JosefEly/RadRandom-RNG-project/README.md

# RadRandom-RNG-project
Schematics and code for a hardware RNG project

This project works using a smoke detector AM-241 source and a reverse-biased photodiode. When an alpha particle hits the detector, this registers as a voltage spike which is converted to a digital signal by a comparator (with hysterisis to avoid turning one detection event into two). An Arduino measures the time between two sets of pulses - if A is greater than B, it's a 1, if A < B, it's a 0, and if they are equal, it tries again recursively. Because the generator can only generate so many bits at a time, these bits are generated and then cached, and each roll pulls from the cached file. Because radioactive decay is random at the quantum level, the bits should be too. A Python verison of the NIST statistical test suite thought the bits were in fact random. I attached the results here.

https://github.com/ozel/DIY_particle_detector/wiki

This was used for the alpha detector in the project.
