JosefEly/RadRandom-RNG-project/RNG Board.kicad_pcb

## KiCad design RNG Board.kicad_pcb (2026-10-23)

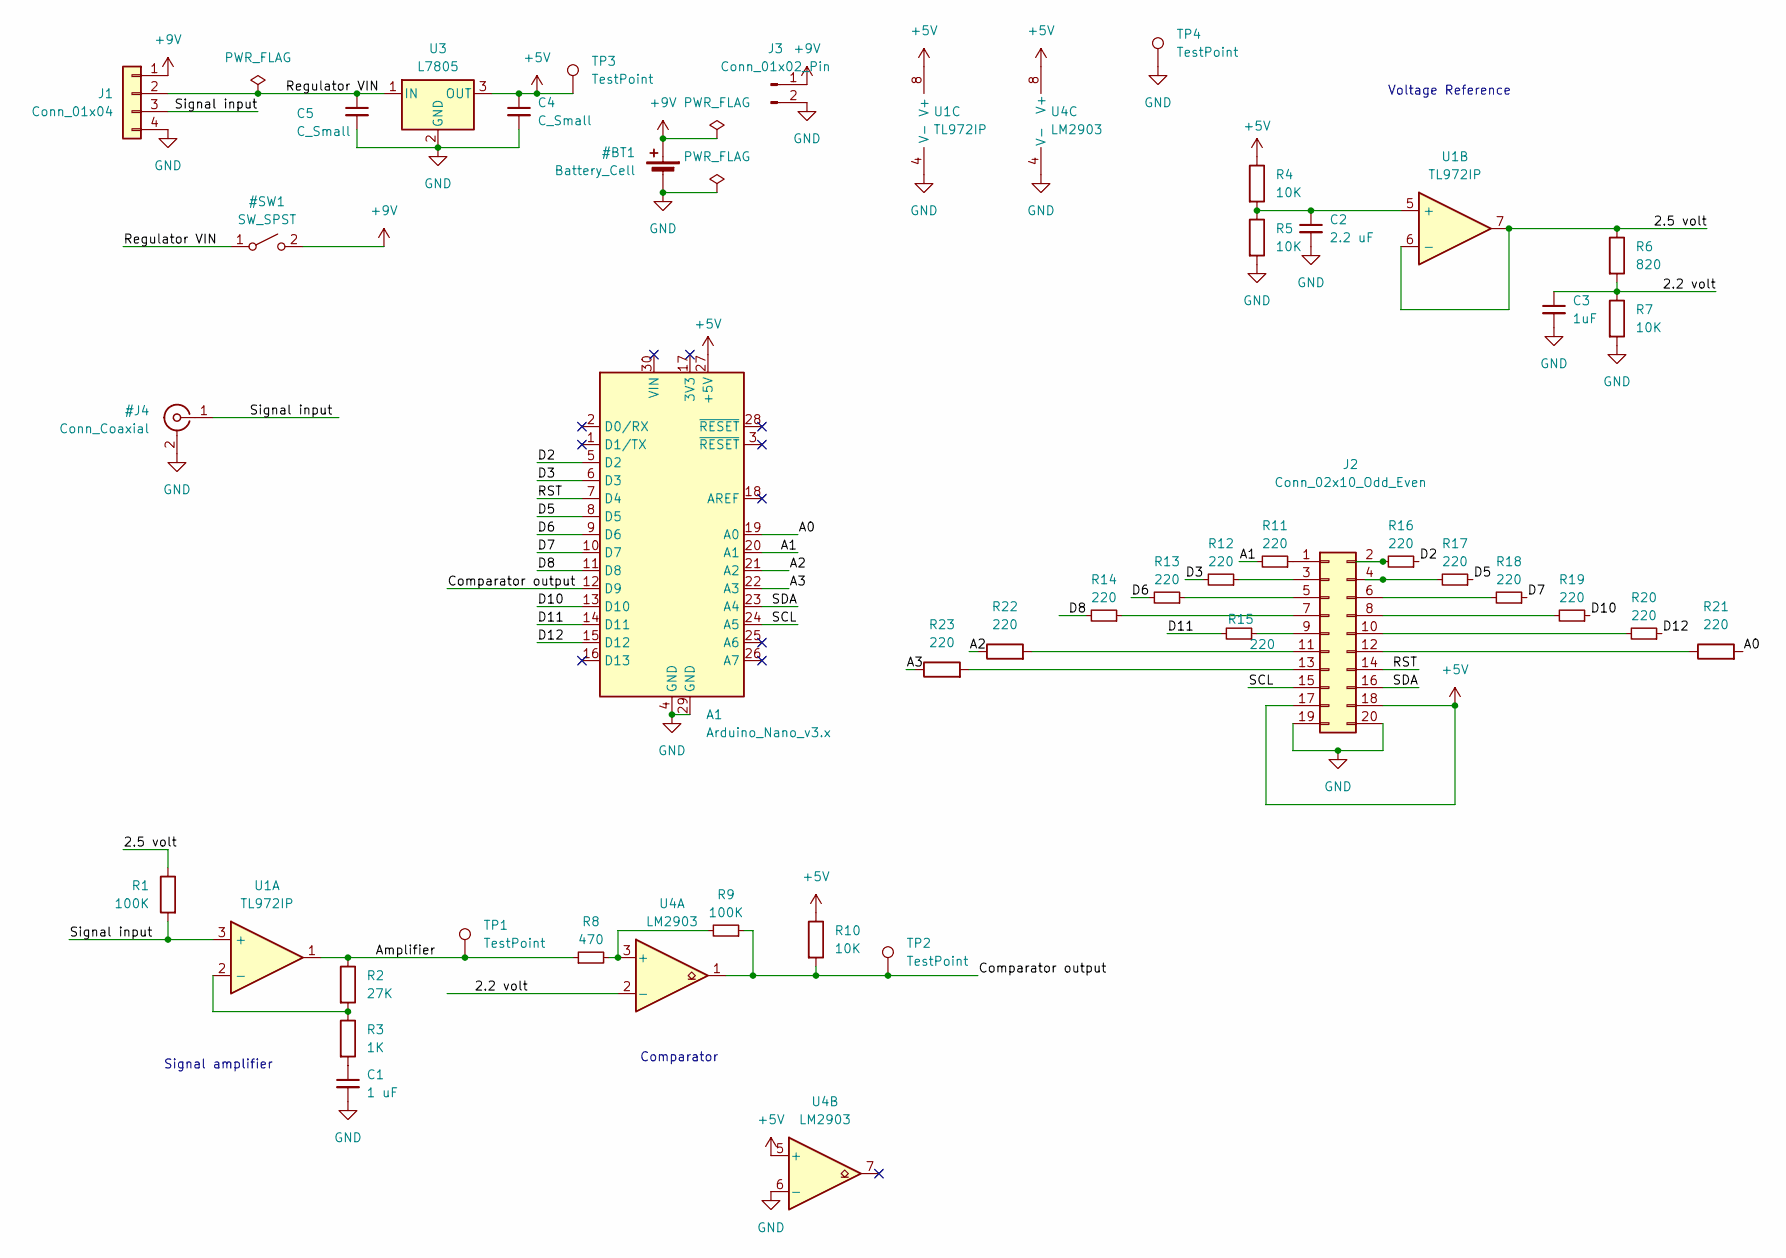
[picture p1: schematic RNG Board.kicad_sch]

Parts:
A1: Arduino_Nano_v3.x; Arduino_Nano
C1: 1 uF; C_Disc_D4.3mm_W1.9mm_P5.00mm
C2: 2.2 uF; C_Disc_D4.3mm_W1.9mm_P5.00mm
C3: 1uF; C_Disc_D4.3mm_W1.9mm_P5.00mm
C4, C5: C_Small; C_Disc_D4.3mm_W1.9mm_P5.00mm
J1: Conn_01x04; PinHeader_1x04_P2.54mm_Vertical
J2: Conn_02x10_Odd_Even; PinHeader_2x10_P2.54mm_Vertical
J3: Conn_01x02_Pin; SolderWire-0.5sqmm_1x02_P4.6mm_D0.9mm_OD2.1mm
R1, R9: 100K; R_Axial_DIN0207_L6.3mm_D2.5mm_P7.62mm_Horizontal
R2: 27K; R_Axial_DIN0207_L6.3mm_D2.5mm_P7.62mm_Horizontal
R3: 1K; R_Axial_DIN0207_L6.3mm_D2.5mm_P7.62mm_Horizontal
R4, R5, R7, R10: 10K; R_Axial_DIN0207_L6.3mm_D2.5mm_P7.62mm_Horizontal
R6: 820; R_Axial_DIN0207_L6.3mm_D2.5mm_P7.62mm_Horizontal
R8: 470; R_Axial_DIN0207_L6.3mm_D2.5mm_P7.62mm_Horizontal
R11, R12, R13, R14, R15, R16, R17, R18, R19, R20, R21, R22, R23: 220; R_Axial_DIN0207_L6.3mm_D2.5mm_P7.62mm_Horizontal
TP1, TP2, TP3, TP4: TestPoint; TestPoint_THTPad_1.5x1.5mm_Drill0.7mm
U1: TL972IP; DIP-8_W7.62mm
U3: L7805; TO-220-3_Vertical
U4: LM2903; DIP-8_W7.62mm

Connections:
+5V: A1.27 (+5V), C4.1, J2.17, J2.18, R4.1, R10.1, TP3.1, U1.8 (V+), U3.3 (OUT), U4.5 (+), U4.8 (V+)
/2.2 volt: C3.1, R6.2, R7.1, U4.2 (-)
/2.5 volt: R1.1, R6.1, U1.6 (-), U1.7
/A0: A1.19 (A0), R21.2
/A1: A1.20 (A1), R11.2
/A2: A1.21 (A2), R22.1
/A3: A1.22 (A3), R23.1
/Amplifier: R2.1, R8.1, TP1.1, U1.1
/Comparator output: A1.12 (D9), R9.1, R10.2, TP2.1, U4.1
/D2: A1.5 (D2), R16.1
/D3: A1.6 (D3), R12.2
/D5: A1.8 (D5), R17.1
/D6: A1.9 (D6), R13.2
/D7: A1.10 (D7), R18.1
/D8: A1.11 (D8), R14.2
/D10: A1.13 (D10), R19.1
/D11: A1.14 (D11), R15.2
/D12: A1.15 (D12), R20.1
/RST: A1.7 (D4), J2.14
/SCL: A1.24 (A5), J2.15
/SDA: A1.23 (A4), J2.16
unnamed: C1.1, R3.2
unnamed: J2.1, R11.1
unnamed: J2.2, R16.2
unnamed: J2.3, R12.1
unnamed: J2.4, R17.2
unnamed: J2.5, R13.1
unnamed: J2.6, R18.2
unnamed: J2.7, R14.1
unnamed: J2.8, R19.2
unnamed: J2.9, R15.1
unnamed: J2.10, R20.2
unnamed: J2.11, R22.2
unnamed: J2.12, R21.1
unnamed: J2.13, R23.2
unnamed: R2.2, R3.1, U1.2 (-)
unnamed: C2.1, R4.2, R5.1, U1.5 (+)
unnamed: R8.2, R9.2, U4.3 (+)

Notes on the sheet:
Signal amplifier
Voltage Reference
Comparator

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
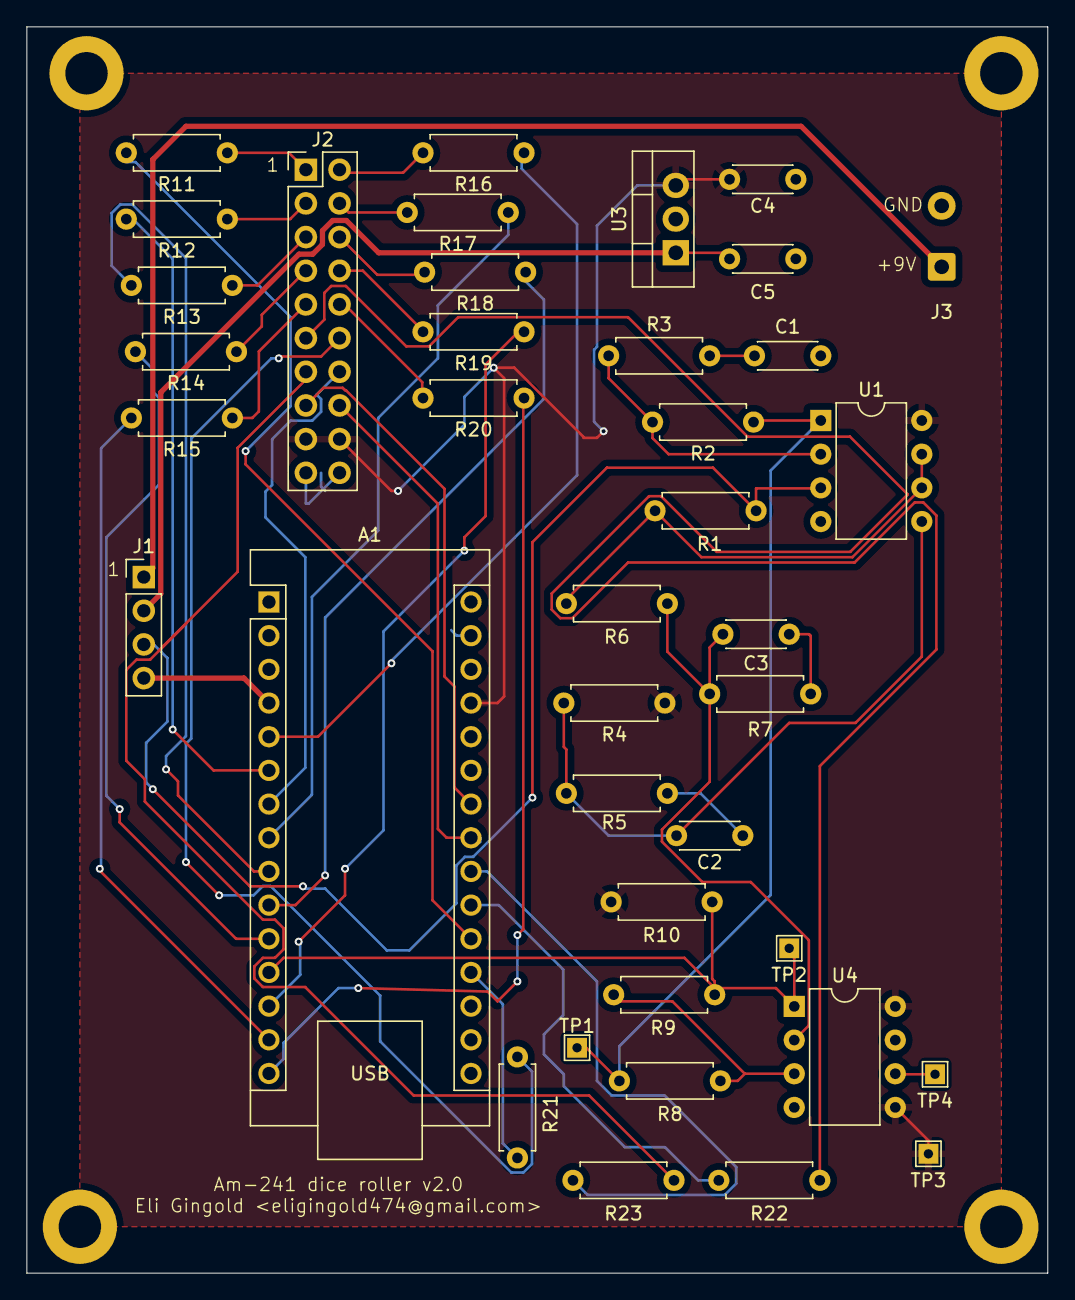
[picture p2: board RNG Board.kicad_pcb from above]

Board: 2 copper layers, 77.0 x 94.0 mm, 39 parts (0 on the bottom side), 42 nets.
