JosefEly/RadRandom-RNG-project/TestReport.txt

Test Data (Direct Input):
10111101000101110110011011000010001110101000100111101001111110001011001000110001110011010000000101101001011110101000011000011101001110111100111110011011110111000100001001011101011111110111110100101101000100001111111011101110101110101100011111011010000000111100101010000110101101000111100110110000100101101101111110010000010101111100011000001001011110110100001001000100000101001110000100100000010110011110101100001111000010011010101000000101010001110110111101000000000000100110000111001000111001001011101100001110110110100000010111010110111011000011111110001110000001101101100111100111011110101010010011110011001010111010000100110101100010010000000100010100000100101101011100101010001101111001011111011000001101111110001001011101001100010000101000101100110001001011111111111110110010100011000001010110001010111000111010001001000100000000101111110011010100101011101010101011011100011100100000001011000000011100100010001000100011001011100110001110001111101011001111110101101111110001011001110111101011110110100001011111100111011100001111001110110111000100000111101100100010001011000011001111111101001011110111111010110010010000000100110001110101010101001001000011000010001000000010001010101101110100100000010001011111010000110011111000110111011011000000010001110001100100100011011100000100110111000011

Type of Test                                      	P-Value             	Conclusion
01. Frequency (Monobit) Test                      	0.5053134016263001  	Random
03. Runs Test                                     	0.1866881589534264  	Random
05. Binary Matrix Rank Test                       	0.29189144494343494 	Random
09. Maurer's "Universal Statistical" Test         	-1.0                	Non-Random
12. Approximate Entropy Test                      	0.7525427189633657  	Random
